thomastech/Sparky/Appreciation.md

# Are You a Sparky Fan?
Sparky the Welder was created by a guy named Thomas (me) who enjoys DiY hacking and making electronic gadgets.

If you find this project interesting then please click the &#9733; (Star) button at the top of the page.
Want to buy me a cup of coffee? That would be fantastic! Here's my ko-fi donate link:  


Your generosity is appreciated. May all your LEDs blink brightly and relays click majestically.
