thomastech/Sparky/Schematics/Schematic_A1.pdf

# MMA STICK WELDER CONTROLLER

# SPARKY

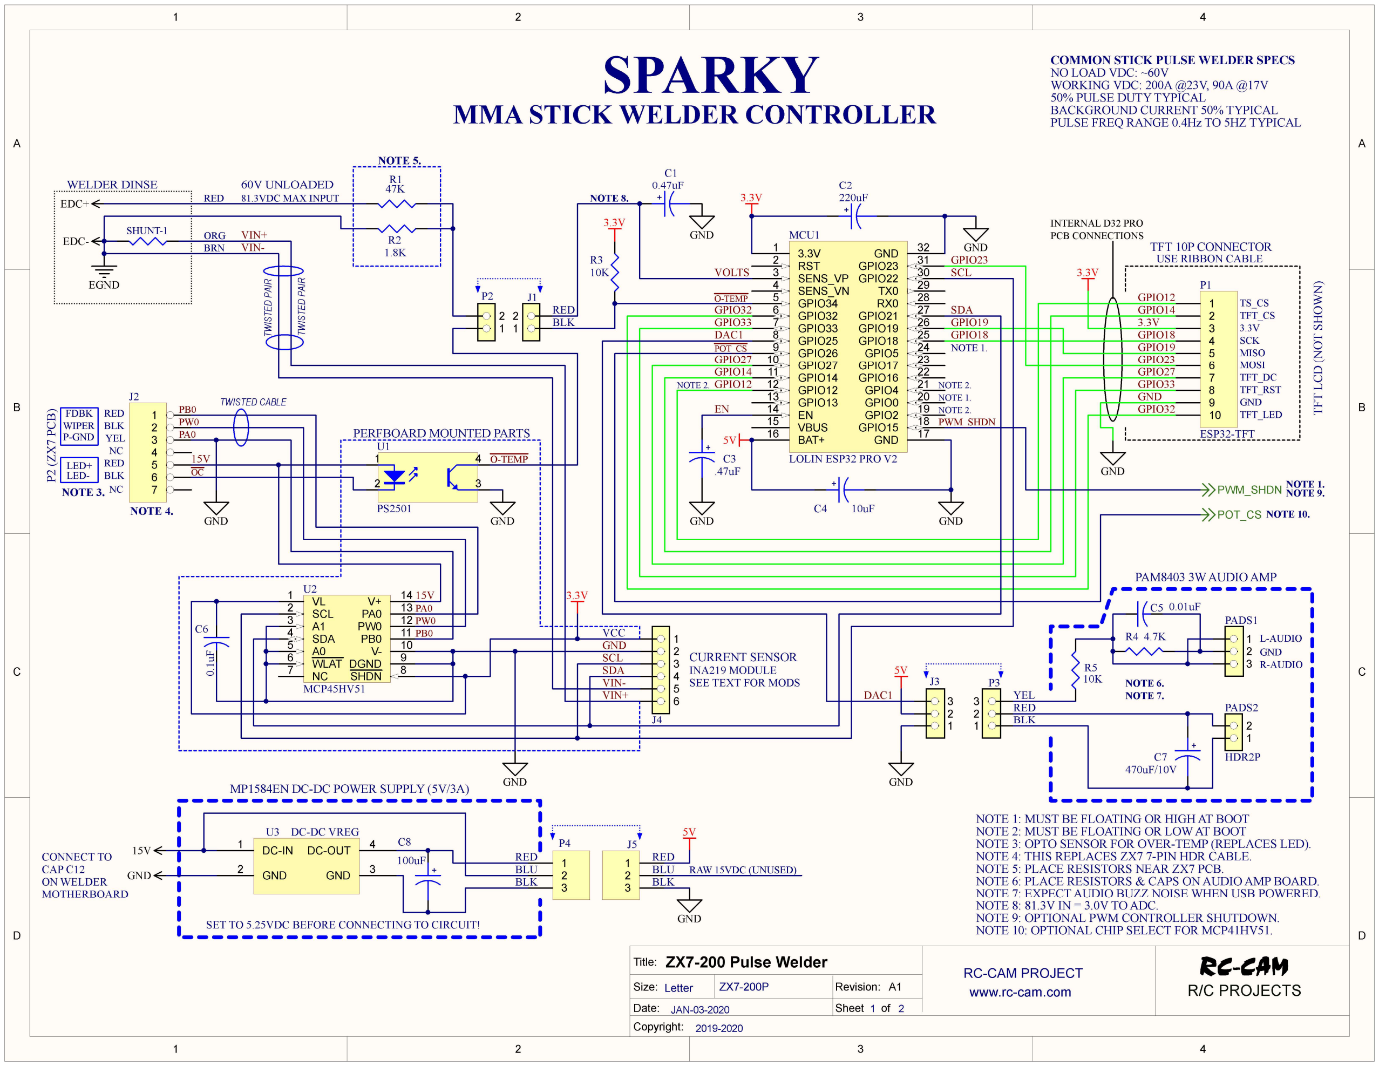
[picture p1: page 1]

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
## ZX7-200 Pulse Welder

ZX7-200P | A1

Title:

Size:
Date:

Revision:
Sheet of

Letter

# RC-CAM

## R/C PROJECTS

### RC-CAM PROJECT www.rc-cam.com

Copyright:

JAN-03-2020
2019-2020

3.3V 1
RST 2
SENS_VP 3
SENS_VN 4
GPIO34 5
GPIO32 6
GPIO33 7
GPIO25 8
GPIO26 9
GPIO27 10
GPIO14 11
GPIO12 12
GPIO13 13
EN 14
VBUS 15
BAT+ 16 | GND | 17 GPIO15 | 18 GPIO2 | 19 GPIO0 | 20 GPIO4 | 21 GPIO16 | 22 GPIO17 | 23 GPIO5 | 24 GPIO18 | 25 GPIO19 | 26 GPIO21 | 27 RX0 | 28 TX0 | 29 GPIO22 | 30 GPIO23 | 31 GND | 32

MCU1

LOLIN ESP32 PRO V2

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
ESP32-TFT

GPIO12
GPIO14
3.3V
GPIO18
GPIO19
GPIO23
GPIO27
GPIO33
GND

TS_CS
TFT_CS
3.3V
SCK
MISO
MOSI
TFT_DC

GND

TFT_RST

TFT_LED

WELDER DINSE | + C1
0.47uF R1
47K

GND

81.3VDC MAX INPUT | NOTE 8. EDC+

VOLTS

TFT 10P CONNECTOR

INTERNAL D32 PRO

GND | TFT LCD ⁽NOT SHOWN⁾

COMMON STICK PULSE WELDER SPECS

50% PULSE DUTY TYPICAL
BACKGROUND CURRENT 50% TYPICAL PULSE FREQ RANGE 0.4Hz TO 5HZ TYPICAL

NOTE 1: MUST BE FLOATING OR HIGH AT BOOT NOTE 2: MUST BE FLOATING OR LOW AT BOOT

WORKING VDC: 200A @23V, 90A @17V

NO LOAD VDC: ~60V

DAC1 | + C2 220uF

+
C4 10uF

+
C3
.47uF

GND

60V UNLOADED

SHUNT-1

5V

3.3V

1

2

4

3

U1

PS2501
GND

INA219 MODULE

CURRENT SENSOR

EDC-

1
2
3
4
5
6
7
J2 P² ⁽ZX⁷ PCB⁾ | RED

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
WIPER

FDBK

P-GND

LED+
LED-

3.3V

GPIO33

GPIO27
GPIO14
GPIO12

EN

GPIO23

GPIO19
GPIO18

NOTE 1.

NOTE 2.

NOTE 2.

NOTE 2.

NOTE 1.

1
2
3

PADS1

PAM8403 3W AUDIO AMP

GPIO32

GPIO32

SCL

SDA

PCB CONNECTIONS

USE RIBBON CABLE

GND

NOTE 3.

NOTE 3: OPTO SENSOR FOR OVER-TEMP (REPLACES LED).

NOTE 4.

NOTE 4: THIS REPLACES ZX7 7-PIN HDR CABLE.

GND

L-AUDIO

R-AUDIO

GND

O-TEMP

PW0

RED

ORG
BRN

NOTE 5: PLACE RESISTORS NEAR ZX7 PCB.

NOTE 5. TWISTED PAIR | TWISTED PAIR

SEE TEXT FOR MODS

R3
10K

3.3V

NOTE 1.

R4 4.7K

1

2

PADS2

HDR2P

+
C7
470uF/10V

NOTE 7: EXPECT AUDIO BUZZ NOISE WHEN USB POWERED.

NOTE 6.

C5 0.01uF

O-TEMP

VL 1
SCL 2
A1 3
SDA 4
A0 5
WLAT 6
NC 7 | SHDN | 8
| DGND | 9
V- | 10 PB0 | 11 PW0 | 12 PA0 | 13 V+ | 14 U2

MCP45HV51

# C6 0.1uF

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
3.3V

VIN-VIN+

TWISTED CABLE

DC-IN 1 | DC-OUT | 4
GND 2 | GND | 3

U3 DC-DC VREG

+

C8
100uF

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
SET TO 5.25VDC BEFORE CONNECTING TO CIRCUIT!

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
CONNECT TO
CAP C12
ON WELDER

MP1584EN DC-DC POWER SUPPLY (5V/3A)

GND

MOTHERBOARD

RAW 15VDC (UNUSED)

15V

VIN+
VIN-

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
BLK 1

2

3

J3
DAC1

5V

NOTE 6: PLACE RESISTORS & CAPS ON AUDIO AMP BOARD.

NOTE 7.

EGND

R2
1.8K

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
NOTE 8: 81.3V IN = 3.0V TO ADC.

PERFBOARD MOUNTED PARTS

PWM_SHDN

POT_CS

NOTE 9: OPTIONAL PWM CONTROLLER SHUTDOWN. NOTE 10: OPTIONAL CHIP SELECT FOR MCP41HV51.

NOTE 9.

NOTE 10.

POT_CS

PWM_SHDN

# PROJECT REFERENCE INFORMATION

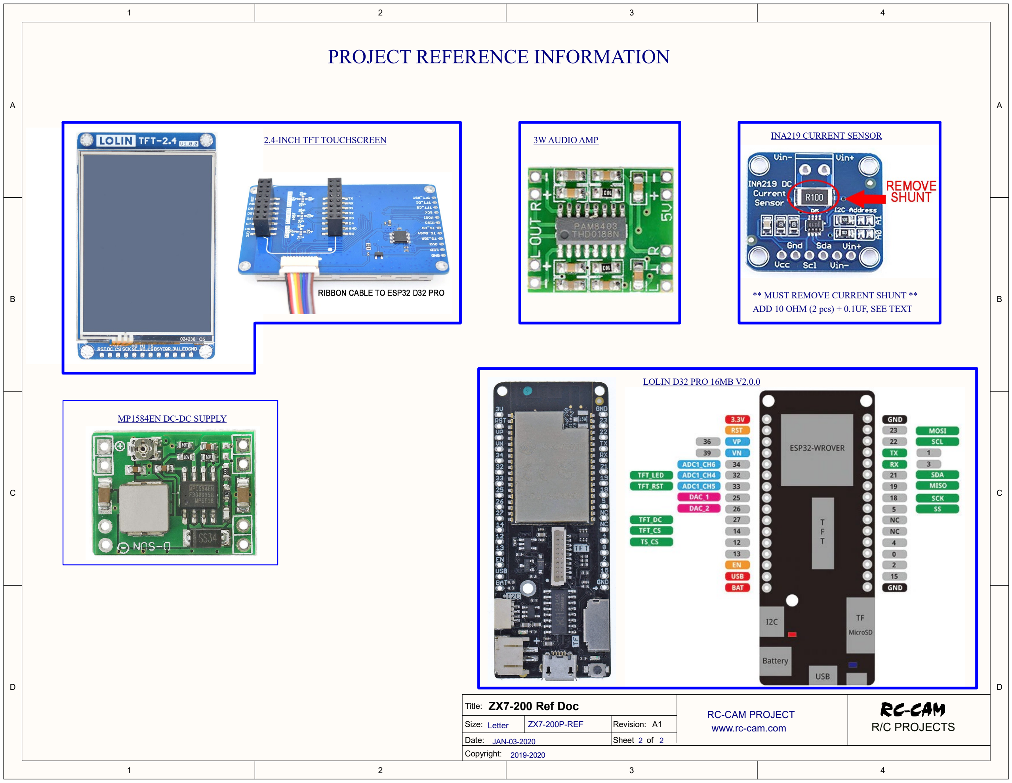
[picture p2: page 2]

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
## ZX7-200 Ref Doc

ZX7-200P-REF | A1

Title:

Size:
Date:

Revision:
Sheet of

Letter

# RC-CAM

## R/C PROJECTS

### RC-CAM PROJECT www.rc-cam.com

Copyright:

JAN-03-2020
2019-2020
2.4-INCH TFT TOUCHSCREEN | 3W AUDIO AMP | INA219 CURRENT SENSOR

** MUST REMOVE CURRENT SHUNT **

LOLIN D32 PRO 16MB V2.0.0

ADD 10 OHM (2 pcs) + 0.1UF, SEE TEXT

MP1584EN DC-DC SUPPLY
