thomastech/Sparky/src/PulseWelder/src/icons.h

/*
   File: icons.h
   Project: ZX7-200 MMA Stick Welder Controller with Pulse Mode.
   Version: 1.0
   Creation: Sep-11-2019
   Revised: Oct-24-2019
   Release: Oct-30-2019
   Author: T. Black
   (c) copyright T. Black 2019, Licensed under GNU GPL 3.0 and later, under this license absolutely no warranty is given.
   This Code was formatted with the uncrustify extension.

   Notes: Graphic arrays are created using JPG or PNG images. File conversion is performed using
   the tool found here: https://www.skaarhoj.com/FreeStuff/GraphicDisplayImageConverter.php
 */

// 45 x 60
static const uint8_t arrowDnBitmap[] PROGMEM = {
  B00000000, B00000000, B00000000, B00000000, B00000000, B00000111,
  B00000000, B00000000, B00000000, B00000000, B00000000, B00000111,
  B01100000, B00000000, B00000000, B00000000, B00000000, B00110111,
  B01110000, B00000000, B00000000, B00000000, B00000000, B01110111,
  B01111000, B00000000, B00000000, B00000000, B00000000, B11110111,
  B01111110, B00000000, B00000000, B00000000, B00000011, B11110111,
  B01111111, B00000000, B00000000, B00000000, B00000111, B11110111,
  B01111111, B10000000, B00000000, B00000000, B00001111, B11110111,
  B01111111, B11100000, B00000000, B00000000, B00111111, B11110111,
  B01111111, B11110000, B00000000, B00000000, B01111111, B11110111,
  B01111111, B11111000, B00000000, B00000000, B11111111, B11110111,
  B01111111, B11111110, B00000000, B00000011, B11111111, B11110111,
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
  B00000000, B00000000, B00000000, B00000000, B00000000, B00000000, B00000000, B00000000, B00000000, B00000000, B00000000,
  B00000000, B00000000, B00000000, B00000000, B00000000, B00000000, B00000000, B00000000, B00000000, B00000000, B00000000, B00000000,
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
};

// EOF
