thomastech/Sparky/(commit log)

2019-10-18 Added Schematic Set, zip file.
    The zip schematic set contains two pages.
2019-10-30 Uploaded Project Source Files.
    Arduino Project for VSCode / Platformio builds.
2019-10-30 Uploaded STL Files.
    Complete set of STL files for Sparky.
2019-12-30 Created Readme for ESP32 BLE library.
2020-01-10 Fixed issue when using SPI not I2C for dig pot.
    [digPot.cpp]
2020-01-14 Sound and Screen Handling refactoring
    - Sound handling through dedicated local class to reduce lines of code
    instead of directly using DacAudio low level actions
    - Screen handling factored a couple of commonly used code blocks
    into separate functions.
2020-01-15 Fixed voice issues, revised version comments.
    [PulseWelder.cpp, PulseWelder.h, screen.cpp, screen.h, speaker.cpp, speaker.h]
